Open3DV/xema_hardware/(commit log)

2022-10-26 增加电路和结构设计文件
    [XEMA Jetson Nano Carrier Board.sch, XEMA-S structural components.stp]
2022-11-01 加入XEMA-L的机械结构step文件
2022-11-03 修改XEMA-S的视锥体
